apachebcn/apachebcn_PresostatoAguaBidon/config_pins.h

// Switches
#define PIN_SWITCH_LEDS_HIGH A0
#define PIN_SWITCH_FORCE_RELAY_ON 13
#define PIN_SWITCH_FORCE_RELAY_OFF 12

// Leds
#define PIN_SCAN_LED 10  // Testigo led de pulso
#define PIN_LEVEL_LED 6  // Testigo led de Nivel
#define PIN_ELECTRODE1_LED 7  // Testigo led de Electrodo 1 cerrado
#define PIN_ELECTRODE2_LED 8  // Testigo led de Electrodo 2 cerrado
#define PIN_RELAY_LED 9  // Testigo led de Relé ON
#define PIN_GND_PWM_LED 11  // Canal Pwm para el control de brillo de los leds

// Generadores de pulsos
#define PIN_LEVEL_PULSE 3  // Le entrega pulso de voltaje al nivel. Va al pin 1 del dispositivo
#define PIN_ELECTRODES_PULSE 4  // Le entrega pulso de voltaje al electrodo 1


// Lector de datos
#define PIN_LEVEL_READ_DATA 2  // Lectura del Nivel. Va al pin 2 del dispositivo
#define PIN_ELECTRODE1_READ_DATA A3  // Lectura del Electrodo 1
#define PIN_ELECTRODE2_READ_DATA A2  // Lectura del Electrodo 2

// Salida a relé
#define PIN_RELE 5

// Buzzer
#define PIN_BUZZER A1
